upirox/esp32-nuki-fingerprint/copricavo-anteprima.png

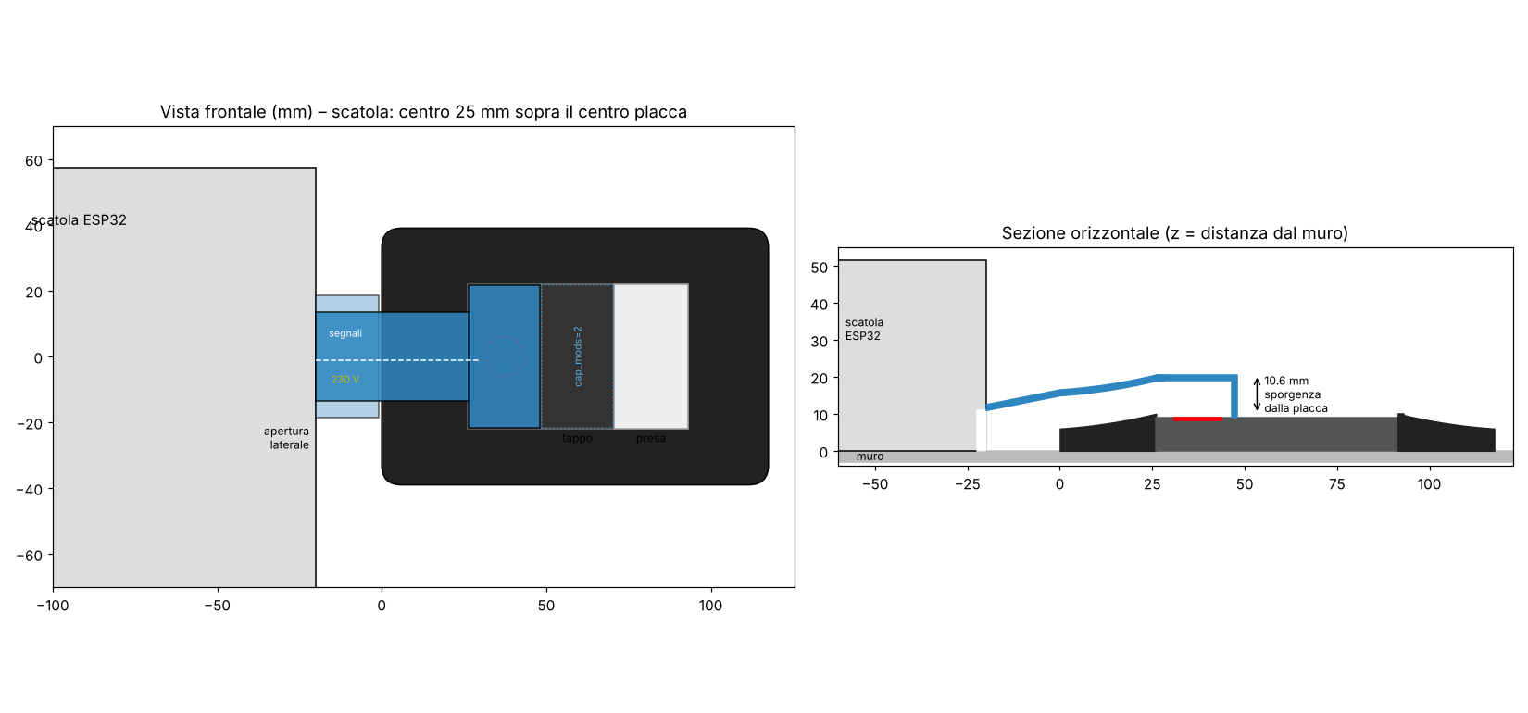
copricavo-anteprima.png
