upirox/esp32-nuki-fingerprint/placca-anteprima.png

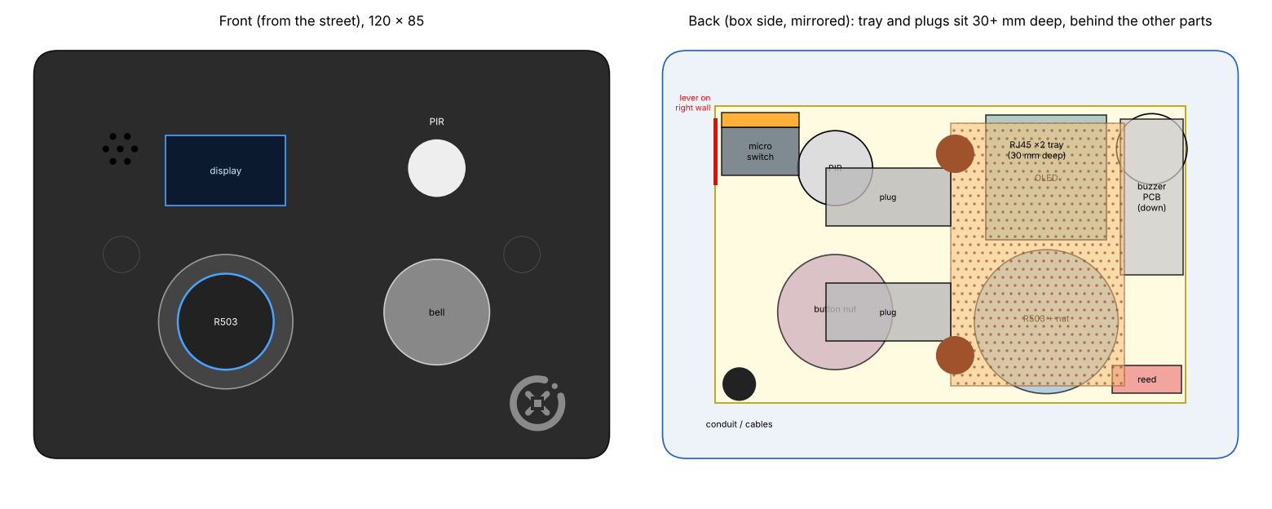
placca-anteprima.png
