upirox/esp32-nuki-fingerprint/plate-power-strip.png

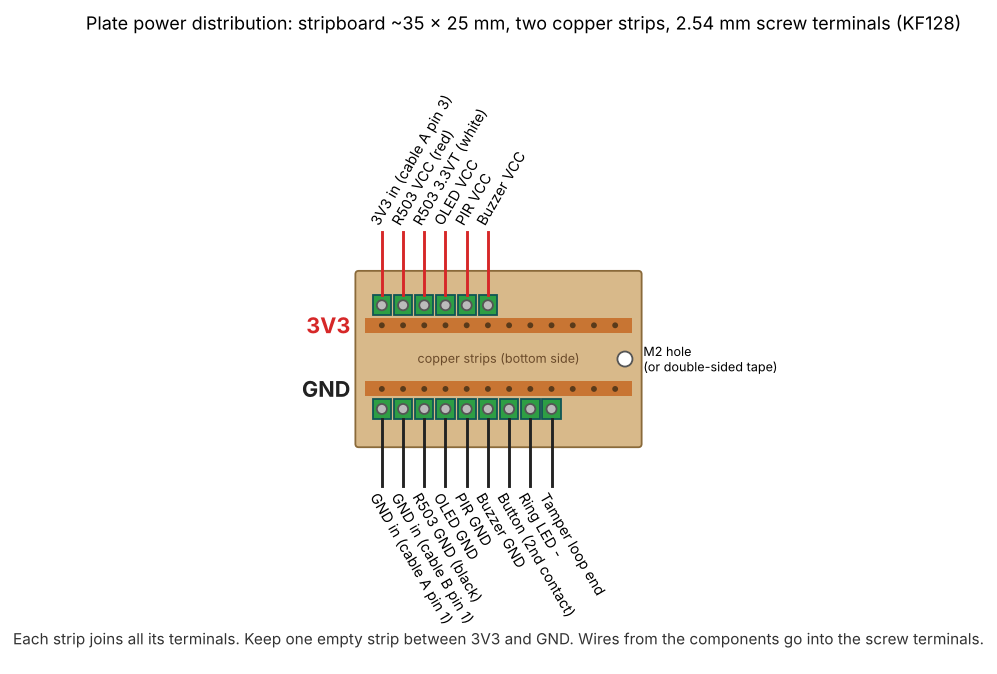
plate-power-strip.png
