upirox/esp32-nuki-fingerprint/scatola-esp32-anteprima.png

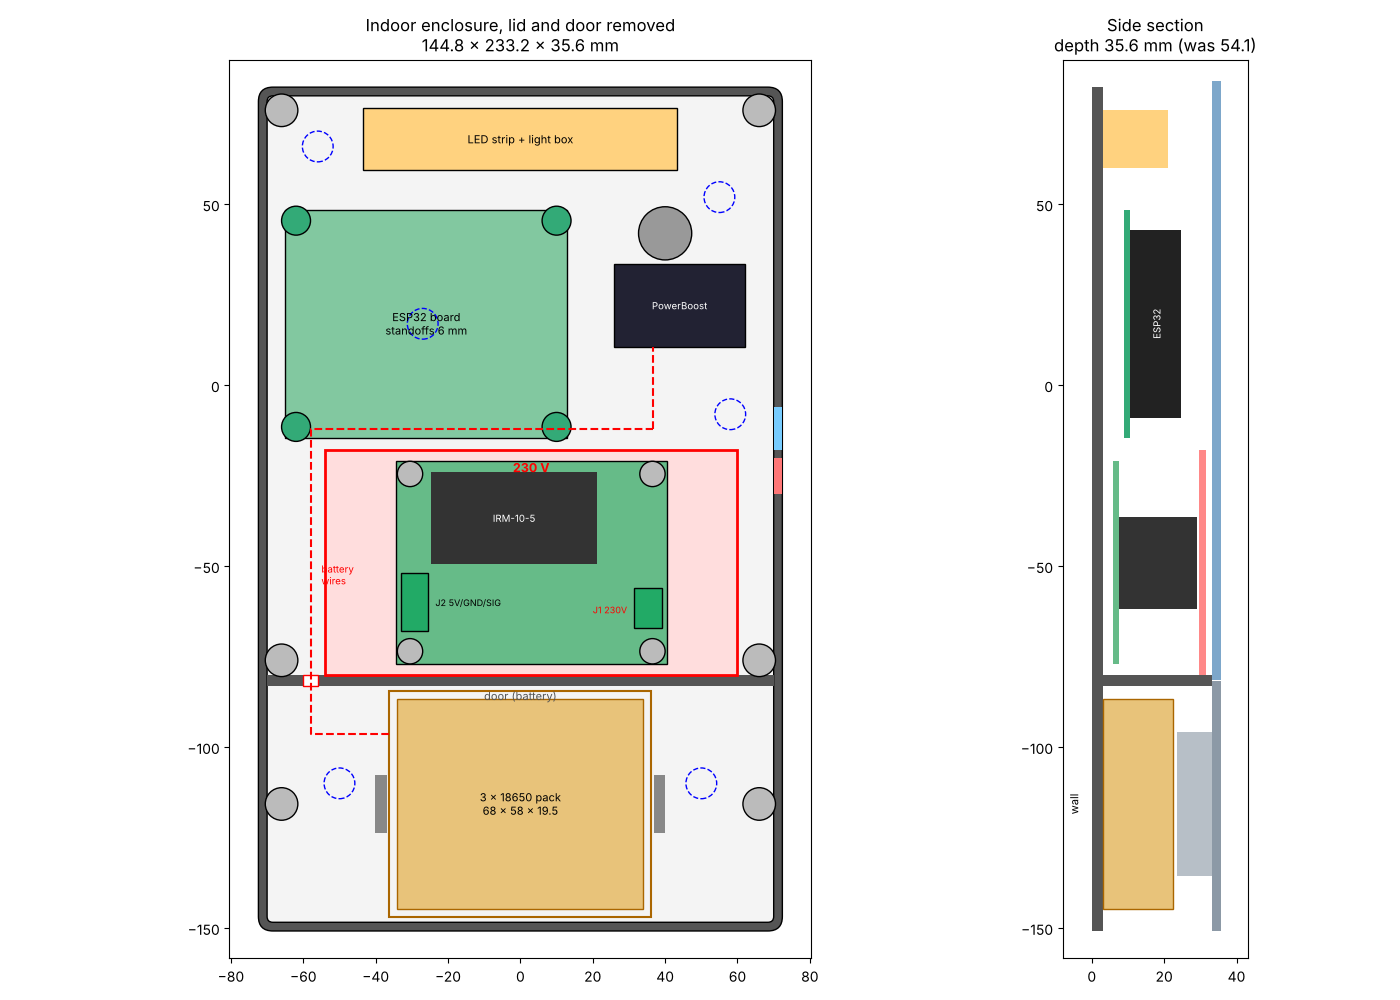
scatola-esp32-anteprima.png
