upirox/esp32-nuki-fingerprint/placca-503-campanello.scad

// ============================================================
//  Custom plate for an Italian 503 wall box (3-module flush box)
//  0.96" SPI OLED display | R503 fingerprint reader | AM312 PIR |
//  doorbell push button | buzzer
//  Tamper: lever microswitch pressed by the box wall + reed switch (magnet
//  glued inside the box), in series
//  Perimeter seal: 2 mm rubber cord (nitrile or closed-cell silicone
//  foam) pressed into a groove on the back (seal = "cord"), or a TPU
//  gasket printed separately or as multi-material (seal = "tpu").
//
//  CORD: cut it as long as the groove, starting on one side of the drain
//  gap at the bottom and ending on the other. Push it into the groove
//  without pulling (if you stretch it, it shrinks back later) and seal
//  both ends with a drop of cyanoacrylate. It protrudes ~0.5 mm and gets
//  squeezed when the screws are tightened.
//
//  It screws straight onto the 503 box (83.5 mm screw spacing) instead
//  of the standard frame + cover plate.
//  All dimensions are in mm and can be changed below.
//  Before printing the final version, print a low-density test and
//  check the holes against the real parts.
// ============================================================

use <oxid_logo.scad>

/* [Plate] */
plate_w      = 120;   // width
plate_h      = 85;    // height (covers the unplastered edge around the box)
plate_t      = 3.5;   // thickness (the R503 nut clamps up to ~10 mm)
corner_r     = 5;     // corner radius
edge_chamfer = 0.8;   // front edge chamfer

/* [OXID icon, engraved on the front, bottom-right] */
pl_logo       = true;
pl_logo_size  = 16;    // width (mm); simplified chip (no pins): strokes >= 0.65 mm
pl_logo_x     = 45;    // centre, seen from the street
pl_logo_y     = -31;
pl_logo_depth = 0.6;   // engraving depth (fill with paint, or leave it plain)

/* [503 box screws] */
screw_pitch  = 83.5;  // standard 503 screw spacing
screw_d      = 3.6;   // through hole
screw_head_d = 7;     // countersunk head (screw_caps = false)
screw_head_h = 2;
// Hidden screws: each head sits in a counterbore closed by a flush printed
// cap (part = "screw_cap", print 2, same colour as the plate, front face on
// the bed). A 5 x 1 mm magnet glued in the cap holds it on the steel screw
// head (stainless screws are not magnetic: use a dot of neutral silicone).
// Remove it with a pin or a small suction cup. A boss on the back (it fits in
// the 2.5 mm recess of the box rim) keeps enough plastic under the head.
screw_caps   = true;
cb_d         = 7.6;   // counterbore (cheese / pan head up to 7 mm)
head_h       = 2.2;   // screw head height (MEASURE IT)
cap_t        = 1.6;   // cap thickness (flush with the plate face)
cap_clear    = 0.1;   // per side: tight press fit, the magnet does the rest
cap_mag_d    = 5;     // magnet in the cap (0 = none)
cap_mag_h    = 1;
screw_boss_d = 11;    // boss on the back around the screw hole
screw_boss_h = 2.3;   // < box_recess (2.5): it never touches the box rim

/* [0.96" OLED display (25.2 x 26 board)] */
oled_x       = -20;   // board centre position (left column, above the reader)
oled_y       = 16;
oled_pcb_w   = 25.2;
oled_pcb_h   = 26;
oled_win_w   = 23;    // visible window (active area ~21.7 x 10.9)
oled_win_h   = 12.5;
oled_win_dy  = 1.5;   // window centre relative to board centre (+ = towards the pins)
oled_glass_t = 1.7;   // glass thickness above the PCB = standoff height
oled_hole_dx = 20.8;  // board hole spacing, horizontal
oled_hole_dy = 21.6;  //                   vertical
oled_pin_d   = 1.7;   // pins that go into the board holes (secure with heat or glue)
oled_pin_h   = 3.5;
oled_post_d  = 4;

/* [R503 reader (M25 thread, 28 mm flange)] */
r503_x       = -20;   // left column, below the display
r503_y       = -14;
r503_hole_d  = 25.6;  // M25 thread clearance

/* [AM312 PIR (~10 mm lens, 12 mm wide)] */
pir_x        = 24;   // right column, above the push button
pir_y        = 18;
pir_hole_d   = 10.2;  // the lens goes through, the 12 mm rim seats against the plate
pir_boss_h   = 3;     // centring ring behind the plate
pir_boss_w   = 1.6;

/* [Vandal-proof doorbell button (22 head, 19 hole, 14 thread, 27 depth)] */
btn_x        = 24;   // right column, below the PIR
btn_y        = -12;
btn_hole_d   = 19.3;  // 19 mm mounting hole + clearance

/* [Buzzer (32.5 x 13 module, hidden behind the plate)] */
buzz_x        = -42;   // centre of the buzzer cylinder (top-left corner)
buzz_y        = 22;
buzz_d        = 12;    // buzzer cylinder diameter
buzz_h        = 9.5;   // cylinder height above the PCB
buzz_ring_h   = 6;     // height of the retaining ring
buzz_ring_w   = 1.2;
buzz_pcb_dir  = 1;     // (only for the optional post) the module can be turned freely:
                       // point its PCB DOWN, beside the display, away from the OLED wires
buzz_hole_off = 9.5;   // distance of the module's M3 hole from the buzzer centre
buzz_use_post = false; // the post would land on the OLED board: the module
                       // is held by the ring + a drop of hot glue
buzz_post_d   = 6;     // post for the module screw
buzz_screw_d  = 2.5;   // hole for an M3 self-tapping screw (or 2.9 mm)
sound_hole_d  = 1.4;   // small sound holes
sound_holes   = true;  // false = solid plate (much quieter sound)

/* [Reed tamper switch (14 x 3.2 mm body, 14 mm leads)] */
// The reed sits in a cradle on the back, parallel to the bottom edge of
// the box. The magnet (6 x 2 mm) is glued to the inside wall of the box,
// facing ONE END of the reed body.
reed_x        = -41;   // centre of the reed body (bottom-left, close to the box bottom wall)
reed_y        = -26;   // closer to the box edge = stronger magnet effect
reed_len      = 14.4;  // 14 mm body + clearance
reed_w        = 3.5;   // 3.2 mm body + clearance
reed_wall     = 1.2;   // cradle wall thickness
reed_wall_h   = 3.4;   // wall height (the reed fits completely inside)

/* [503 box (BTicino-type datasheet) and how it sits in the wall] */
box_in_w     = 98.2;  // inner opening
box_in_h     = 62;
box_recess   = 2.5;   // box rim behind the wall surface (measured 2-3 mm)
box_depth    = 55;    // from the wall surface to the bottom of the box

/* [Lever microswitch tamper (standard 28 x 16 x 10, C/NO/NC)] */
// The switch sits inside the box, against a fin printed on the back of the
// plate, with its lever facing a side inner wall of the box. When the plate
// is screwed on, the lever slides along the box rim and stays pressed by the
// inner wall (ms_side): plate removed = lever released = alarm. Wired in series with
// the reed. Cut the lever to ms_lever_over mm beyond the body and bend it so
// that its tip stands ~4 mm off the body: test with a multimeter that it
// clicks when pressed flat against a wall ms_wall_gap mm from the body.
use_ms        = true;
ms_side       = 1;      // 1 = right inner wall (top-right corner), -1 = left
ms_L          = 28;     // body length (along the depth of the box)
ms_H          = 16;     // body height: lever side faces the box wall
ms_T          = 10;     // body thickness (screws go through it)
ms_y          = 21.5;   // centre of the body thickness (top-left corner of the box)
ms_wall_gap   = 1.5;    // lever face of the body to the box inner wall
ms_lever_over = 10;     // lever length beyond the front end of the body (cut it)
ms_hole_d     = 3.1;    // body holes (MEASURE: standard V switch 3.1 mm,
ms_hole_pitch = 22.2;   //  22.2 mm apart, 5.1 mm from the side opposite
ms_hole_side  = 5.1;    //  the lever)
ms_fin_t      = 3;      // fin the switch is screwed to (M3 self-tapping, or M2.5 + nut)
ms_pilot_d    = 2.6;

/* [RJ45 breakout pair (33 x 48 board, two jacks), on a tray behind the display] */
// The two breakouts (still joined, 33 x 48) lie on a tray screwed to two posts
// of the plate, ~30 mm behind it: everything on the plate (reader, display,
// button) is shallower. The jacks face RIGHT (towards the push button side,
// as seen from the street) and the plugs come from the conduit in the
// bottom-right corner. Wires from the plate parts reach the screw terminals
// on the left end. The tray is a separate part (part = "rj45_tray"),
// printed flat, held by 2 M3 self-tapping screws; the boards by 2 cable ties.
// Checked on the real boards: jack on one short end, lever terminals at the
// other end (wires enter from the end opposite the jack).
use_rj45      = true;
rj_len        = 33;     // board length, jack end to terminal end (along x)
rj_w          = 48;     // the two boards side by side (along y)
rj_jack_x     = 0;      // x of the jack end of the boards (seen from the street)
rj_jack_h     = 14;     // jack height above the board (preview only, MEASURE)
rj_floor_z    = 30;     // tray underside, mm behind the plate's back
rj_floor_t    = 2.5;
rj_rail       = 3;      // side rails that keep the boards in place
rj_post_d     = 8;
rj_post_y     = 21;     // posts at (rj_jack_x - 1, +/- rj_post_y)

/* [Seal] */
part             = "all";      // "plate", "screw_cap", "rj45_tray", "gasket" (TPU only) or "all" (preview)
seal             = "cord";   // "cord" (rubber cord in the groove), "tpu" or "none"

/* [Rubber cord] */
cord_d           = 2;        // cord diameter
groove_w         = 2.0;      // groove width: = diameter, the cord stays in place
                             // (2.1 if it is hard to push in; closed-cell silicone foam: groove_depth 1.1)
groove_depth     = 1.45;     // depth: protrudes ~0.55 mm, ~27% squeeze
groove_inset     = 3;        // distance from the plate edge to the groove
                             // (for a 3 mm cord: groove_w 3, depth 2.2, plate_t 4)

/* [TPU gasket (only if seal = "tpu")] */
gasket_inset     = 2.5;      // distance from the plate edge
gasket_w         = 3;        // bead width
gasket_h         = 1.6;      // height (squeezed to ~1 mm when the screws are tight)
gasket_groove    = 0.6;      // depth of the seat in the plate
gasket_drain     = 6;        // gap at the bottom to let condensation out (0 = closed)

$fn = 96;

// ------------------------------------------------------------

module rounded_rect(w, h, r, t) {
    linear_extrude(t)
        offset(r) square([w - 2*r, h - 2*r], center = true);
}

module plate_body() {
    // body with a chamfer on the front edge (front face = z 0)
    hull() {
        translate([0, 0, edge_chamfer])
            rounded_rect(plate_w, plate_h, corner_r, plate_t - edge_chamfer);
        rounded_rect(plate_w - 2*edge_chamfer, plate_h - 2*edge_chamfer,
                     corner_r - edge_chamfer, plate_t);
    }
}

module screw_hole() {
    if (screw_caps) {
        translate([0, 0, -0.01]) cylinder(d = screw_d, h = plate_t + screw_boss_h + 0.02);
        // counterbore: cap on top of the screw head
        translate([0, 0, -0.01]) cylinder(d = cb_d, h = cap_t + head_h + 0.01);
    } else {
        translate([0, 0, -0.01]) cylinder(d = screw_d, h = plate_t + 0.02);
        // countersink on the front
        translate([0, 0, -0.01])
            cylinder(d1 = screw_head_d, d2 = screw_d, h = screw_head_h);
    }
}
module screw_bosses() {
    if (screw_caps) for (sx = [-1, 1]) translate([sx*screw_pitch/2, 0, plate_t - 0.01])
        cylinder(d = screw_boss_d, h = screw_boss_h + 0.01);
}
// cap, front face on the bed (z = 0)
module screw_cap() {
    difference() {
        cylinder(d = cb_d - 2*cap_clear, h = cap_t);
        // small chamfer on the front edge: the joint becomes a fine line
        translate([0, 0, -0.01]) difference() {
            cylinder(d = cb_d, h = 0.31);
            cylinder(d1 = cb_d - 2*cap_clear - 0.6, d2 = cb_d - 2*cap_clear, h = 0.31);
        }
        if (cap_mag_d > 0) translate([0, 0, cap_t - cap_mag_h])
            cylinder(d = cap_mag_d + 0.2, h = cap_mag_h + 0.01);
    }
}
if (screw_caps) echo(str("SCREWS: ", plate_t + screw_boss_h - cap_t - head_h,
         " mm of plastic under the heads; caps: part = screw_cap (print 2)"));

module oled_window() {
    translate([oled_x, oled_y + oled_win_dy, -0.01])
    hull() {
        // window with a bevelled edge towards the front (easier to read from the side)
        linear_extrude(0.01)
            offset(1) square([oled_win_w + 2, oled_win_h + 2] - [2, 2], center = true);
        translate([0, 0, plate_t])
            linear_extrude(0.02)
                offset(0.5) square([oled_win_w, oled_win_h] - [1, 1], center = true);
    }
}

module oled_mounts() {
    for (sx = [-1, 1], sy = [-1, 1])
        translate([oled_x + sx*oled_hole_dx/2, oled_y + sy*oled_hole_dy/2, plate_t]) {
            cylinder(d = oled_post_d, h = oled_glass_t);
            cylinder(d = oled_pin_d, h = oled_glass_t + oled_pin_h);
        }
}

module pir_boss() {
    translate([pir_x, pir_y, plate_t])
        difference() {
            cylinder(d = 12.4 + 2*pir_boss_w, h = pir_boss_h);
            translate([0, 0, -0.01]) cylinder(d = 12.4, h = pir_boss_h + 0.02);
        }
}

module buzzer_mount() {
    // ring holding the buzzer cylinder, facing the plate
    translate([buzz_x, buzz_y, plate_t])
        difference() {
            cylinder(d = buzz_d + 0.3 + 2*buzz_ring_w, h = buzz_ring_h);
            translate([0, 0, -0.01]) cylinder(d = buzz_d + 0.3, h = buzz_ring_h + 0.02);
        }
    // post for the screw: the PCB rests on the buzzer and is fixed here
    if (buzz_use_post)
    translate([buzz_x + buzz_pcb_dir*buzz_hole_off, buzz_y, plate_t])
        difference() {
            cylinder(d = buzz_post_d, h = buzz_h);
            translate([0, 0, 2]) cylinder(d = buzz_screw_d, h = buzz_h);
        }
}

module sound_grille() {
    // 7 small honeycomb holes in front of the buzzer
    if (sound_holes)
        for (p = concat([[0, 0]], [for (a = [0:60:300]) [3*cos(a), 3*sin(a)]]))
            translate([buzz_x + p[0], buzz_y + p[1], -0.01])
                cylinder(d = sound_hole_d, h = plate_t + 0.02, $fn = 24);
}

module reed_cradle() {
    // U cradle open at the ends for the leads; close it with hot glue
    translate([reed_x, reed_y, plate_t])
        difference() {
            translate([-(reed_len)/2, -(reed_w/2 + reed_wall), 0])
                cube([reed_len, reed_w + 2*reed_wall, reed_wall_h]);
            translate([-(reed_len)/2 - 0.1, -reed_w/2, -0.01])
                cube([reed_len + 0.2, reed_w, reed_wall_h + 0.02]);
        }
}

// perimeter ring (plan view) w wide at distance inset from the edge,
// with a drain gap at the bottom
module ring_2d(inset, w) {
    ow = plate_w - 2*inset;
    oh = plate_h - 2*inset;
    r  = max(corner_r - inset, 0.5);
    ri = max(r - w, 0.1);
    difference() {
        offset(r) square([ow - 2*r, oh - 2*r], center = true);
        offset(ri) square([ow - 2*w - 2*ri, oh - 2*w - 2*ri], center = true);
        if (gasket_drain > 0)
            translate([-gasket_drain/2, -plate_h/2 - 1]) square([gasket_drain, w + inset + 2]);
    }
}
module gasket_ring_2d() { ring_2d(gasket_inset, gasket_w); }
module groove_ring_2d() { ring_2d(groove_inset, groove_w); }

// cord (preview only): protrudes from the back of the plate
module cord_preview() {
    translate([0, 0, plate_t - groove_depth])
        linear_extrude(cord_d) offset(-(groove_w - cord_d)/2) groove_ring_2d();
}

// the gasket starts at the bottom of its seat and protrudes gasket_h from the back
module gasket() {
    translate([0, 0, plate_t - gasket_groove])
        linear_extrude(gasket_groove + gasket_h) gasket_ring_2d();
}

// lever microswitch: z of the front end of the body (towards the plate) so that
// the cut lever tip reaches the box rim
ms_z0 = plate_t + box_recess + 1 + ms_lever_over;
ms_xf = ms_side*(box_in_w/2 - ms_wall_gap);       // lever face of the body
ms_x0 = ms_side > 0 ? ms_xf - ms_H : ms_xf;        // body x range: ms_x0 .. ms_x0 + ms_H
ms_xh = ms_side > 0 ? ms_x0 + ms_hole_side : ms_x0 + ms_H - ms_hole_side;  // screw holes

module microswitch_fin() {
    // fin above the switch (towards the top wall of the box), from the plate up
    fy = ms_y + ms_T/2;
    difference() {
        union() {
            translate([ms_x0, fy, plate_t - 0.5])
                cube([ms_H, ms_fin_t, ms_z0 + ms_L - plate_t + 0.5]);
            // gussets at the base
            for (gx = [ms_x0 + 1.5, ms_x0 + ms_H - 1.5 - 2])
                translate([gx, fy, plate_t - 0.5])
                    rotate([90, 0, 90]) linear_extrude(2)
                        polygon([[0, 0], [-4, 0], [0, 9]]);
        }
        // holes for the switch screws
        for (dz = [-ms_hole_pitch/2, ms_hole_pitch/2])
            translate([ms_xh, fy - 0.1, ms_z0 + ms_L/2 + dz])
                rotate([-90, 0, 0]) cylinder(d = ms_pilot_d, h = ms_fin_t + 0.2, $fn = 24);
    }
}

// preview only: switch body and lever
module microswitch_preview() {
    color("DarkSlateGray")
        translate([ms_x0, ms_y - ms_T/2, ms_z0]) cube([ms_H, ms_T, ms_L]);
    color("Silver")   // lever, pressed against the wall
        hull() {
            translate([ms_xf + ms_side*0.25 - 0.25, ms_y - 2, ms_z0 + ms_L - 3]) cube([0.5, 4, 0.5]);
            translate([ms_xf + ms_side*(ms_wall_gap - 0.55) - 0.25, ms_y - 2, ms_z0 - ms_lever_over]) cube([0.5, 4, 0.5]);
        }
}

// RJ45 tray: posts on the plate, tray printed separately
rj_x0 = rj_jack_x - rj_len;           // terminal end of the boards
rj_posts = [[rj_jack_x - 1, rj_post_y], [rj_jack_x - 1, -rj_post_y]];

module rj45_posts() {
    for (p = rj_posts) translate([p[0], p[1], plate_t - 0.5])
        difference() {
            cylinder(d = rj_post_d, h = rj_floor_z + 0.5, $fn = 32);
            translate([0, 0, rj_floor_z - 8]) cylinder(d = 2.6, h = 9, $fn = 20);  // M3 self-tapping
        }
}

// tray in its own coordinates, underside at z = 0 (as printed)
module rj45_tray() {
    tw = rj_w + 0.6 + 2*rj_rail;           // overall width (y)
    tl = rj_len + 0.6 + rj_rail;           // overall length (x), open on the jack side
    difference() {
        union() {
            translate([rj_x0 - 0.3 - rj_rail, -tw/2, 0]) cube([tl, tw, rj_floor_t]);
            // low stop at the terminal end (1.5 mm: lower than the board, so it
            // never covers the wire entries of the lever terminals) and rails
            // on the two long sides (height 4)
            translate([rj_x0 - 0.3 - rj_rail, -tw/2, 0]) cube([rj_rail, tw, rj_floor_t + 1.5]);
            for (sy = [-1, 1]) translate([rj_x0 - 0.3 - rj_rail, sy > 0 ? tw/2 - rj_rail : -tw/2, 0])
                cube([tl, rj_rail, rj_floor_t + 4]);
            // stiffening ribs underneath, between the posts
            translate([rj_jack_x - 4, -rj_post_y, -0.01]) cube([3, 2*rj_post_y, rj_floor_t]);
        }
        // screw holes over the posts (countersunk on top)
        for (p = rj_posts) translate([p[0], p[1], -0.1]) {
            cylinder(d = 3.4, h = rj_floor_t + 0.2, $fn = 20);
            translate([0, 0, rj_floor_t - 1.6]) cylinder(d1 = 3.4, d2 = 6.4, h = 1.7, $fn = 24);
        }
        // cable tie slots across the boards
        for (sy = [-1, 1]) translate([rj_x0 + rj_len*0.45 - 2, sy*(rj_w/2 + 0.3 + rj_rail/2) - 0.9, -0.1])
            cube([4, 1.8, rj_floor_t + 4.2]);
    }
}

module rj45_preview() {
    translate([0, 0, plate_t + rj_floor_z]) {
        color("Peru") rj45_tray();
        color("DarkGreen") translate([rj_x0, -rj_w/2, rj_floor_t]) cube([rj_len, rj_w, 1.6]);
        for (sy = [-1, 1]) color("Silver")
            translate([rj_jack_x - 16, sy*rj_w/4 - 8, rj_floor_t + 1.6]) cube([16, 16, rj_jack_h]);
    }
}

module plate() {
difference() {
    union() { plate_body(); screw_bosses(); }

    // gasket seat on the back
    if (seal == "tpu")
        translate([0, 0, plate_t - gasket_groove])
            linear_extrude(gasket_groove + 0.01) gasket_ring_2d();
    // groove for the rubber cord
    if (seal == "cord")
        translate([0, 0, plate_t - groove_depth])
            linear_extrude(groove_depth + 0.01) groove_ring_2d();

    sound_grille();

    for (sx = [-1, 1]) translate([sx*screw_pitch/2, 0, 0]) screw_hole();

    oled_window();

    // small logo, engraved on the front face
    if (pl_logo) translate([pl_logo_x, pl_logo_y, -0.01])
        linear_extrude(pl_logo_depth + 0.01) oxid_icon_2d(pl_logo_size, simple = true);

    translate([r503_x, r503_y, -0.01]) cylinder(d = r503_hole_d, h = plate_t + 0.02);
    translate([pir_x,  pir_y,  -0.01]) cylinder(d = pir_hole_d,  h = plate_t + 0.02);
    translate([btn_x,  btn_y,  -0.01]) cylinder(d = btn_hole_d,  h = plate_t + 0.02);
}

oled_mounts();
pir_boss();
buzzer_mount();
reed_cradle();
if (use_ms) microswitch_fin();
if (use_rj45) rj45_posts();
}

// All x positions in this file are "seen from the street". The front face is
// at z = 0 and the back towards +z, so the street looks at the plate from -z,
// where +x would appear on the LEFT: mirror everything on x, so that the
// printed plate matches the layout as seen from the street (and the logo
// reads the right way).
mirror([1, 0, 0]) {
if (part == "plate" || part == "all") plate();
if (screw_caps && part == "screw_cap") screw_cap();
if (screw_caps && part == "all") for (sx = [-1, 1])
    color("DimGray") translate([sx*screw_pitch/2, 0, -12]) screw_cap();
if (use_rj45 && part == "rj45_tray") rj45_tray();
if (use_rj45 && part == "all") rj45_preview();
if (seal == "tpu" && (part == "gasket" || part == "all")) color("DimGray") gasket();
if (seal == "cord" && part == "all") color("Black") cord_preview();
if (use_ms && part == "all") microswitch_preview();
}
echo(str("MICROSWITCH: body from ", ms_z0 - plate_t, " to ", ms_z0 + ms_L - plate_t,
         " mm behind the plate, terminals to ", ms_z0 + ms_L + 8 - plate_t,
         " (box depth ", box_depth, "). Lever cut to ", ms_lever_over, " mm beyond the body."));

// The front face is the one on the print bed (z = 0):
// print it like this, no supports. The back faces up.
