upirox/esp32-nuki-fingerprint/power schema.pdf

# UPS wiring with PowerBoost 1000C

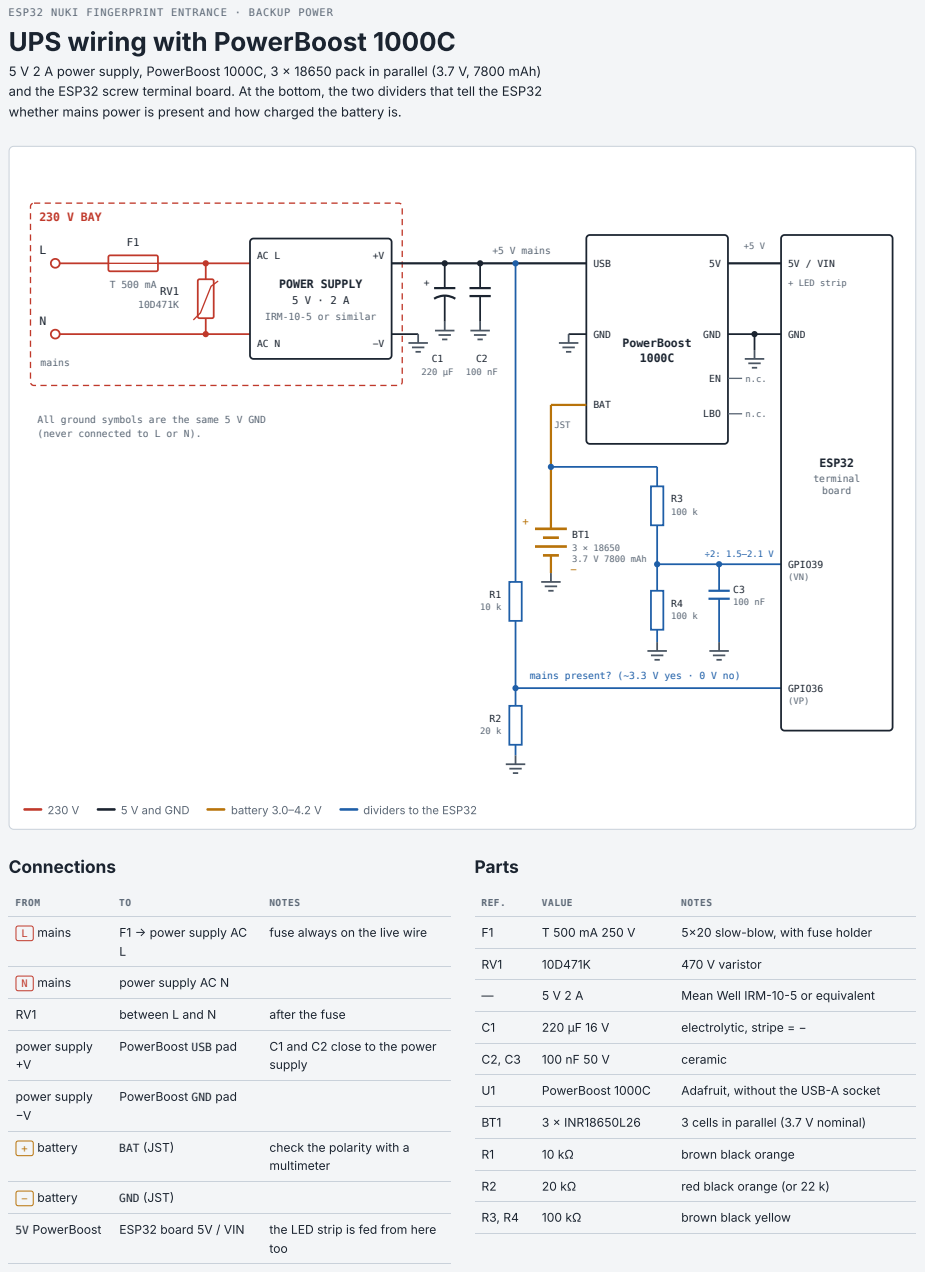
[picture p6: page 1]

ESP32 NUKI FINGERPRINT ENTRANCE · BACKUP POWER

5 V 2 A power supply, PowerBoost 1000C, 3 × 18650 pack in parallel (3.7 V, 7800 mAh)
and the ESP32 screw terminal board. At the bottom, the two dividers that tell the ESP32
whether mains power is present and how charged the battery is.

All ground symbols are the same 5 V GND
(never connected to L or N).

mains present? (~3.3 V yes · 0 V no)

fuse always on the live wire

FROM | TO | NOTES

GND
PowerBoost

ESP32 board GND

power supply

+V

R1 → GPIO36 → R2 →
GND

"mains present" sensor

BAT | R3 → GPIO39 → R4 →
| GND

C3 between GPIO39 and GND

EN, LBO | not connected | LBO must not go to a GPIO

## Before powering up

1. Connect the battery to the PowerBoost first and measure 5V–GND at the output: you should read about 5.1–5.2 V. The PowerBoost does not work without a battery.
2. With the ESP32 disconnected, power the supply and measure GPIO36 (on the wire that will go to the pin): about 3.3 V with mains, 0 V without.
3. Measure the point between R3 and R4: it must be half the battery voltage, i.e. 2.0 V if the pack is at 4.0 V.
4. Only then connect the ESP32 board and try cutting the mains: the ESP32 must not reboot.

## Safety

The battery pack and the PowerBoost sit outside the 230 V bay, away from the power supply, which gets warm.
The PowerBoost charger chip gets very hot while charging: that's normal, but keep it somewhere ventilated.

No battery wire may be left bare: a shorted 18650 heats up within seconds.
R1–R2 take the 5 V from the power supply output, never from the 230 V side.
