upirox/esp32-nuki-fingerprint/(commit log)

2026-10-21 Batteria di backup, scatola con pacco 18650, placca con cordone
    nuki_fingerprint.yaml
    - sensori "Alimentazione di rete" (GPIO36) e "Tensione batteria" /
    "Batteria" (GPIO39) per il PowerBoost 1000C
    - modalita' risparmio durante il blackout: striscia al 30%, anello
    del pulsante spento a riposo e al 60% col display acceso
    scatola-esp32-interna.scad
    - 145 x 155 x 51 mm: pacco 3 x 18650 sotto la scheda ESP32,
    PowerBoost a destra, vano 230 V per Mean Well IRM-10-5
    - inserti filettati M3 a caldo, foro cavi diviso dalla parete del vano
    - la versione senza batteria resta nella cronologia (4f17cf4)
    placca-503-campanello.scad
    - solco per cordone di tenuta (nitrile o silicone espanso), placca 3,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
    [placca-503-campanello.scad, scatola-esp32-interna.scad]
2026-10-21 Switch repository to English: comments, docs and images
    - nuki_fingerprint.yaml: all comments and log messages in English
    (entity names and on-screen texts unchanged, so Home Assistant
    entity_ids stay the same)
    - placca-503-campanello.scad / scatola-esp32-interna.scad: comments and
    customizer sections in English; part names are now "plate", "gasket",
    "all" / "base", "lid", "lid230", "diffuser", "all"; seal = "cord"
    - power schema.pdf and scatola-esp32-anteprima.png re-rendered in English
    - add common/base_config.yaml (shared package), secrets.example.yaml,
    .gitignore and an English README
    Claude-Session: https://claude.ai/cod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
    [placca-503-campanello.scad, scatola-esp32-interna.scad]
2026-10-23 Tamper: lever microswitch in series with the reed (no magnetic bypass)
    README and firmware wiring notes updated. No firmware logic change:
    GPIO19 still sees a single contact closed while the plate is mounted.
    Claude-Session: https://claude.ai/code/session_015e9f9p5EFhy5EoRU7fAuGL
2026-10-23 LED status: 144 LEDs/m strip (12 LEDs) with light box and 1.6 mm diffuser
    - Enclosure: led_n 12, led_pitch 1000/144, strip_w 10.6, led_gap 12,
    diff_t 1.6, light box walls hanging from the lid with wire notches
    - Firmware: num_leds 12, scan width 3
    - README and preview updated
    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
    [scatola-esp32-interna.scad]
2026-10-24 Indoor enclosure: mount next to a wall socket
    - Signal cables leave through a slot in the middle of the right wall,
    flush with the back (towards the nearby 503 box and conduit)
    - 230 V enters the bay through an M16 gland in the bottom wall
    - Back cable hole disabled (use_back_hole = true restores it)
    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
    [scatola-esp32-interna.scad]
2026-10-24 Indoor enclosure: single side opening split for signals and 230 V
    - One opening in the right wall, flush with the back, split by the bay's
    top wall extended to the outside
    - 230 V part leads through a closed channel into the bay, with a cable
    tie block for strain relief; bottom gland now optional (off)
    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
    [scatola-esp32-interna.scad]
2026-10-24 Light box: opal acrylic bar diffuser option (default)
    - diff_type = "pmma": 2 mm opal acrylic bar (~83.9 x 13.2) inside the
    light box, against the lid; no pocket in the lid
    - LED rib lowered so LED-to-diffuser distance stays led_gap (12 mm)
    - diff_type = "printed" keeps the printed diffuser in a lid pocket
    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
    [scatola-esp32-interna.scad]
2026-10-24 230 V bay: posts for an 80 x 40 power supply board
    - use_psu_board (default): 4 posts with M3 heat-set inserts, board 8 mm
    above the floor; the bare-module cradle is used only when false
    - Input end on the right (230 V entry), output end on the left (5 V hole)
    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
    [scatola-esp32-interna.scad]
2026-10-24 PSU board posts: 76 x 36 spacing, M2 self-tapping screws
    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
    [scatola-esp32-interna.scad]
2026-10-25 LED strip seat: 12 mm wide PCB
    - strip_w 12.6: rib, rails, light box and acrylic bar (83.9 x 15.2) follow
    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
    [scatola-esp32-interna.scad]
2026-10-25 Indoor enclosure: real ESP32 terminal board (63 x 78, holes 57 x 72)
    - Board upright: terminals left/right, wires go sideways
    - Battery pack lying (long side horizontal) to clear the standoffs
    - Inner height 150 -> 160 (outer 144.8 x 164.8 x 50.6), LED strip at y 68,
    one wall hole moved, PSU board centred in the taller bay
    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
    [scatola-esp32-interna.scad]
2026-10-25 Indoor enclosure: ESP32 board lying, USB-C to the right
    - Board 78 x 63 (holes 72 x 57), terminals on top/bottom with ~10 mm
    of room for the wires; USB-C plug passes over the PowerBoost
    - Battery pack back to vertical, between the standoffs
    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
    [scatola-esp32-interna.scad]
2026-10-25 Antenna connector moved to the top-left, near the ESP32 module
    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
    [scatola-esp32-interna.scad]
2026-10-25 Ventilation: low inlets and high outlets for natural convection
    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
    [scatola-esp32-interna.scad]
2026-10-26 Lid: engraved chip + Wi-Fi logo
    - logo_mode engrave (fill with paint) or inlay (logo_chip / logo_wifi parts
    for multi-material printers), 56 mm, 0.8 mm deep
    - Lid preview image
    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
    [scatola-esp32-interna.scad]
2026-10-27 LED window: printed plug flush with the lid face (default)
    - diff_type = "plug": white PETG plug, 0.8 mm front skin, hollow behind,
    flange glued inside the light box; window size unchanged
    - Opal acrylic and flat printed diffuser kept as options
    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
    [scatola-esp32-interna.scad]
2026-10-27 Insulating separator between battery pack and ESP32 board
    - New part "separator": 1.2 mm plate, board footprint, slides over the
    standoffs and rests on the pack (with air slots)
    - standoff_air 4 -> 5 mm to make room for strap + separator (depth +1 mm)
    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
    [scatola-esp32-interna.scad]
2026-10-28 README: plate connector pinout (2 x RJ45, T568B)
    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
2026-10-28 Plate connector wiring diagram (2 x RJ45)
    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
2026-10-28 Display: neutral idle text, lock state shown by the sensor ring colour
    - Idle: "Appoggia il dito / sul lettore", bottom line "Accesso riservato";
    no more lock state on the display (it faces the street)
    - Sensor ring: blue when locked, aura_unlocked_color (yellow) when
    unlocked/open; refreshed on lock state changes
    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
2026-10-28 Consistent colour code indoors and outdoors
    - Strip: opening counts as moving (yellow); lockout AND tamper = slow red
    blink (new Alarm Blink effect); fast blink stays for a single wrong finger
    - Ring: lockout now blinks red like tamper/disabled; unlocked door = green
    - Colour code documented in the header
    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
    [nuki_fingerprint.yaml]
2026-10-28 Plate 3V3/GND distribution strip diagram
    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
2026-10-30 nuki_lock: back to the component main branch (fixes merged), ESPHome 2026.10
    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
    [nuki_fingerprint.yaml]
2026-11-01 Power Status text sensor (UPS style)
    Online / Online - Charging / On Battery / On Battery - Low, from mains
    sense and cell voltage (charging inferred with 4.12/4.18 V hysteresis).
    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
2026-11-01 Outdoor plate: 120 x 85, lever microswitch fin (box wall actuated)
    - plate_h 80 -> 85 to cover the unplastered edge
    - 503 box geometry parameters (opening, rim recess, depth)
    - fin for a standard 28 x 16 x 10 lever microswitch in the top-left
    corner of the box, lever pressed by the left inner wall; parametric
    so a smaller switch only needs new dimensions
    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
    [placca-503-campanello.scad]
2026-11-01 Outdoor plate: two-column layout
    - Left column: display above the fingerprint reader; right column: PIR
    above the doorbell button; buzzer top-left (PCB pointing down)
    - Microswitch moved to the top-right corner (lever on the right wall),
    reed to the bottom-left; bottom-right corner left free for the cables
    - Front/back layout preview
    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
    [placca-503-campanello.scad]
2026-11-01 Outdoor plate: tray for the two RJ45 breakouts
    - Two posts behind the display carry a separate, flat-printed tray
    (part rj45_tray) ~30 mm behind the plate, deeper than every plate part
    - Jacks face the push-button side, towards the conduit; boards held by
    rails and two cable ties
    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
    [placca-503-campanello.scad]
2026-11-01 RJ45 tray: low end stop so the lever terminals' wire entries stay free
    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
    [placca-503-campanello.scad]
2026-11-01 Power Status: detect charging from power return and cell relaxation
    Voltage thresholds alone missed the charge cycle when the cell was
    already above 4.12 V (e.g. 95%): now mains coming back starts
    'Online - Charging', which ends when the cell relaxes 25 mV below its
    peak (charger stopped) or after 3 h at 4.2 V.
    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
    [nuki_fingerprint.yaml]
2026-11-01 Indoor enclosure: light pipes for the PowerBoost LEDs on the lid
    - Four 2 mm acrylic rods (LOW, DONE, CHRG, PWR) flush with the lid face,
    each in its own tube hanging from the lid (no light leaking between
    DONE and CHRG, 3.6 mm apart); LOW tube stops above the JST connector
    - LED positions from Adafruit's Eagle board file (Rev B); board mounted
    with micro-USB towards the ESP32 and the pad row at the bottom
    - Rod lengths printed in the console; preview updated
    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
    [scatola-esp32-interna.scad]
2026-11-01 Light pipes: divider between DONE and CHRG, rods 0.5 mm above the LEDs
    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
    [scatola-esp32-interna.scad]
2026-11-01 Light pipes: divider stops just above the LED tops (no contact)
    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
    [scatola-esp32-interna.scad]
2026-11-01 Add cable cover from the indoor 503 to the ESP32 box
    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
    [copricavo-503.scad]
2026-11-01 Cable cover: cap over 1 or 2 modules (cap_mods), real module layout in the preview
    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
    [copricavo-503.scad]
2026-11-02 Indoor enclosure: battery pack in a bottom bay with its own door
    The pack is no longer under the board: it lies in a separate bay at the
    bottom (coolest spot), closed by a screwed door, behind a full-height
    dividing wall with a slot for the battery wires. The board sits on 6 mm
    standoffs, so the enclosure goes from 52 to 36 mm deep (145 x 233 mm).
    230 V bay narrowed on the left to leave a corridor for the battery wires,
    supply board posts lowered to 3 mm. Cable cover preview updated.
    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
    [copricavo-503.scad, scatola-esp32-interna.scad]
2026-11-02 Hidden fixings: magnetic lid and battery door, capped plate screws
    Indoor enclosure: lid and battery door held by 8 x 2 mm magnets in pockets
    under a 0.5 mm skin (lid_fix = "magnets", "screws" keeps the old inserts),
    fingernail notches to open them. The 230 V cover stays screwed.
    Outdoor plate: the 503 screws sit in counterbores closed by flush printed
    caps with a small magnet (part = "screw_cap"), 2.3 mm bosses on the back
    keep 2 mm of plastic under the heads.
    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
    [placca-503-campanello.scad, scatola-esp32-interna.scad]
2026-11-03 Nuki component: state lag and GATT cache fixes merged upstream (353cf75)
    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
    [nuki_fingerprint.yaml]
2026-11-03 Outdoor plate: small chip + Wi-Fi logo engraved bottom-right
    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
    [placca-503-campanello.scad]
2026-11-03 OXID logo: icon on the outdoor plate, two-colour wordmark on the lid
    - oxid_logo.scad: wordmark and icon as 2D modules, shared by both parts
    - lid: OXID wordmark, two-colour inlay (logo_dark / logo_accent parts) or
    engraved, replacing the chip + Wi-Fi symbol
    - plate: OXID icon (simplified chip) engraved bottom-right
    - plate: the whole model is now mirrored on x at output: positions are
    given as seen from the street, but the front face is at z = 0 and is
    seen from -z, so the printed layout was left-right swapped
    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
    [oxid_logo.scad, placca-503-campanello.scad, scatola-esp32-interna.scad]
2026-11-04 Indoor enclosure: posts and bay for the 75 x 56 power supply PCB
    - 230 V bay 7 mm taller (inside 58 mm): fits the KiCad board
    alimentatore_5v_sense v1.0 (75 x 56, M3 holes at 67 x 49)
    - board rotated 180 degrees: J1 (230 V) on the right, next to the mains
    entry and the cable tie; J2 (+5V, GND, SIG) on the left, next to the
    hole towards the ESP32 board
    - 4 posts with short M3 heat-set inserts (nylon M3 x 6 screws)
    - side opening 7 mm higher: cable cover alignment 100.4 mm
    - low vent slots moved above the side opening
    - firmware header: mains sense divider now on the power supply PCB
    Claude-Session: https://claude.ai/code/session_0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
    [copricavo-503.scad, scatola-esp32-interna.scad]
